xingrz/USB2TTL/USB2TTL-SCH.pdf

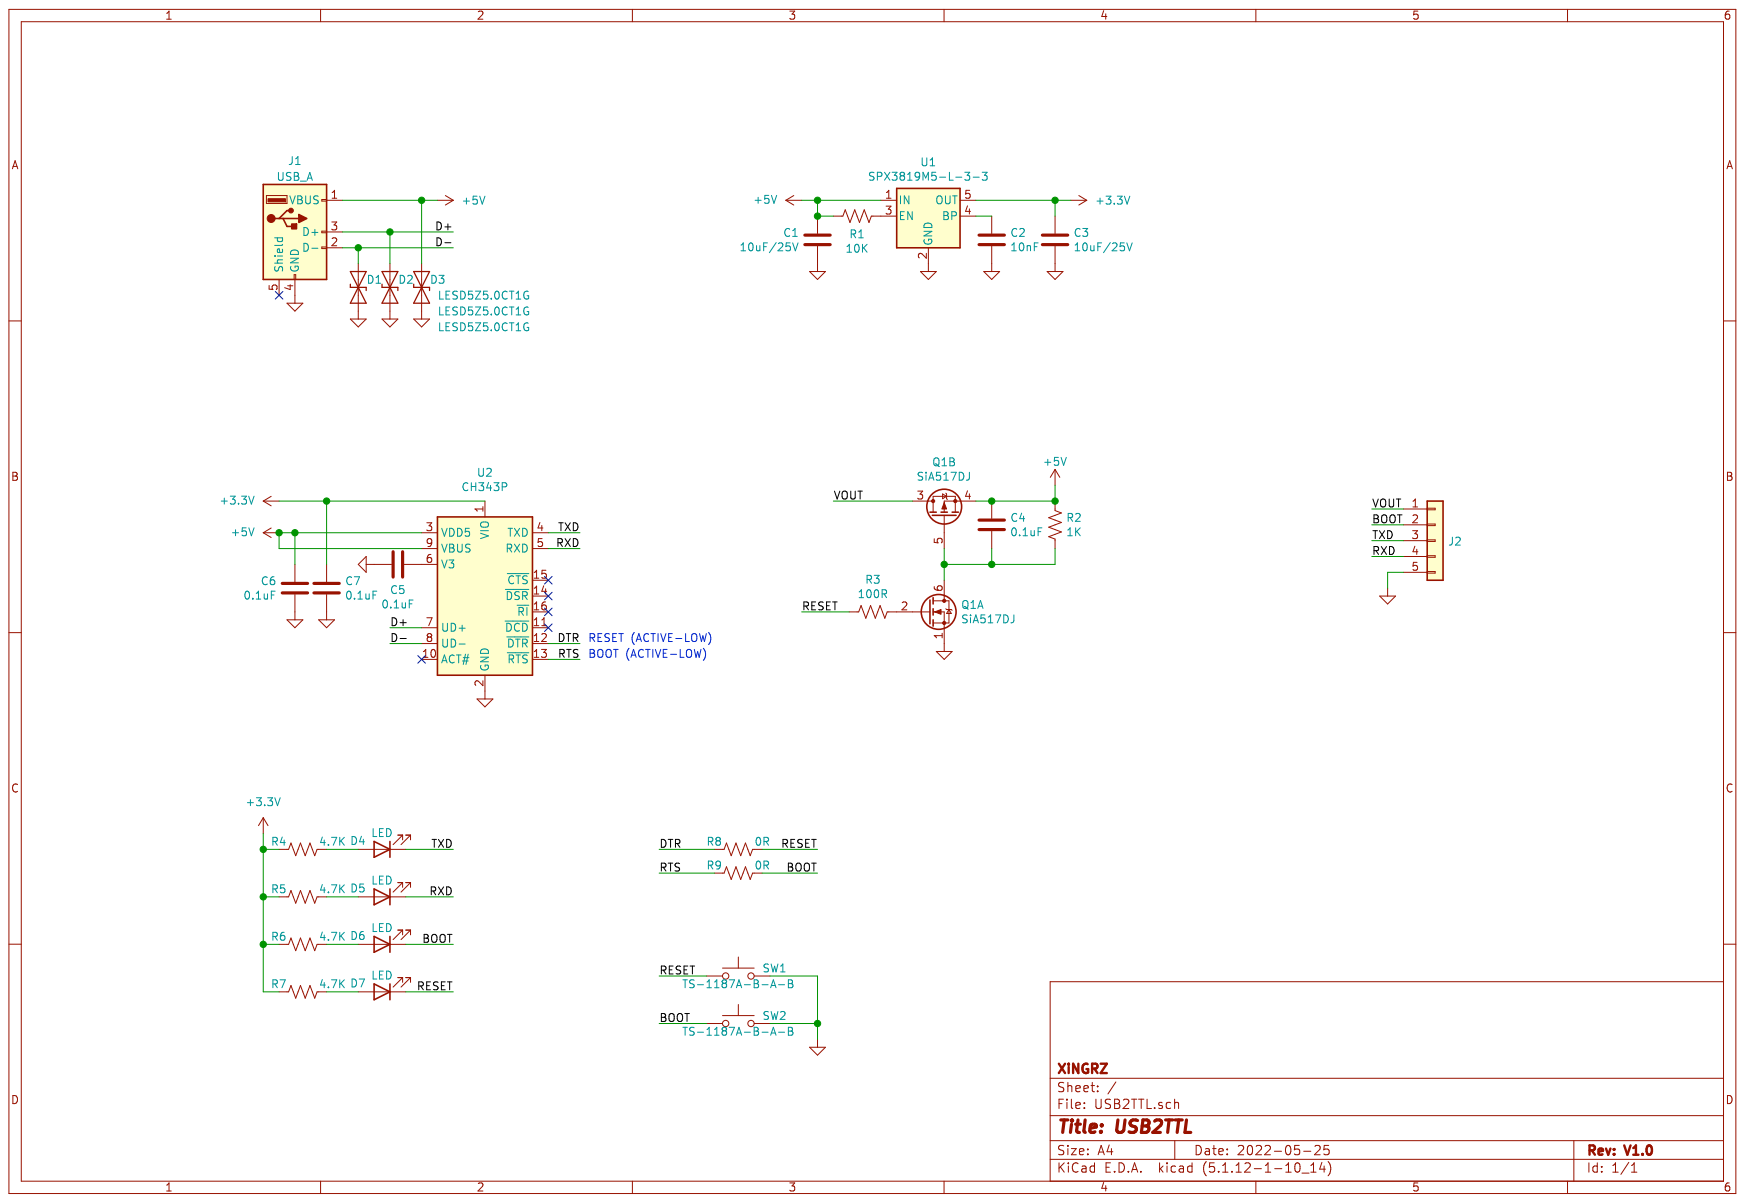
[picture p1: page 1]
