xingrz/USB2TTL/USB2TTL.kicad_pcb

## KiCad design USB2TTL.kicad_pcb (2022-06-01)

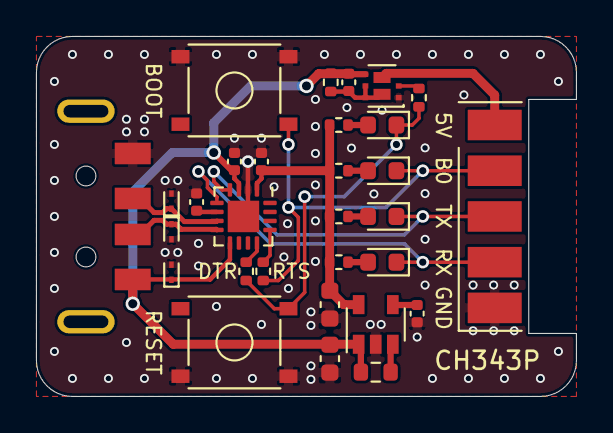
[picture p2: board USB2TTL.kicad_pcb from above]

Board: 2 copper layers, 30.0 x 20.0 mm, 30 parts (0 on the bottom side), 21 nets.

Parts:
C1, C3: 10uF/25V; C_0603_1608Metric
C2: 10nF; C_0402_1005Metric
C4, C5, C6, C7: 0.1uF; C_0402_1005Metric
D1, D2, D3: LESD5Z5.0CT1G; D_SOD-923
D4, D5, D6, D7: LED; LED_0603_1608Metric
J1: USB_A; MOLEX_48037-2200
J2: Conn_01x05; PinHeader_1x05_P2.54mm_Horizontal_SMD
Q1: SiA517DJ; Vishay_PowerPAK_SC70-6L_Dual
R1: 10K; R_0603_1608Metric
R2: 1K; R_0402_1005Metric
R3: 100R; R_0402_1005Metric
R4, R5, R6, R7: 4.7K; R_0402_1005Metric
R8, R9: 0R; R_0402_1005Metric
SW1, SW2: TS-1187A-B-A-B; XKB_TS-1187A-B-A-B
U1: SPX3819M5-L-3-3; SOT-23-5
U2: CH343P; WQFN-16-1EP_3x3mm_P0.5mm_EP1.75x1.75mm

Connections:
+3V3: C3.1, C7.1, R4.2, R5.2, R6.2, R7.2, U1.5, U2.1
+5V: C1.1, C4.1, C6.1, D3.1, J1.1, Q1.4, R1.2, R2.1, U1.1, U2.3, U2.9
/BOOT: D6.1, J2.2, R9.1, SW2.1
/D+: D2.1, J1.3, U2.7
/D-: D1.1, J1.2, U2.8
/DTR: R8.2, U2.12
/RESET: D7.1, R3.2, R8.1, SW1.1
/RTS: R9.2, U2.13
/RXD: D5.1, J2.4, U2.5
/TXD: D4.1, J2.3, U2.4
/VOUT: J2.1, Q1.3
GND: C1.2, C2.2, C3.2, C5.2, C6.2, C7.2, D1.2, D2.2, D3.2, J1.4, J2.5, Q1.1, SW1.2, SW2.2, U1.2, U2.2, U2.17
unnamed: C2.1, U1.4
unnamed: C4.2, Q1.5, Q1.6, R2.2
unnamed: C5.1, U2.6
unnamed: D4.2, R4.1
unnamed: D5.2, R5.1
unnamed: D6.2, R6.1
unnamed: D7.2, R7.1
unnamed: Q1.2, R3.1
unnamed: R1.1, U1.3
