xingrz/USB2TTL/(commit log)

2022-05-25 Basic set up
    [USB2TTL.kicad_pcb, USB2TTL.sch]
2022-05-25 Done V1.0
    [USB2TTL.kicad_pcb, USB2TTL.sch]
2022-05-25 Output gerber
    [USB2TTL-Bottom_Cu.gbr, USB2TTL-Bottom_Mask.gbr, USB2TTL-Bottom_Paste.gbr, USB2TTL-Bottom_Silk.gbr, USB2TTL-EdgeCuts.gbr, USB2TTL-NPTH.drl, USB2TTL-PTH.drl, USB2TTL-Top_Cu.gbr]
2022-06-01 Fix rotation of SiA517DJ
    [USB2TTL.kicad_pcb, USB2TTL.sch]
